FlyingCowsNCSU/FlyingCowsNCSU.github.io/images_and_videos/IMG_20230419_145311804_HDR.jpg

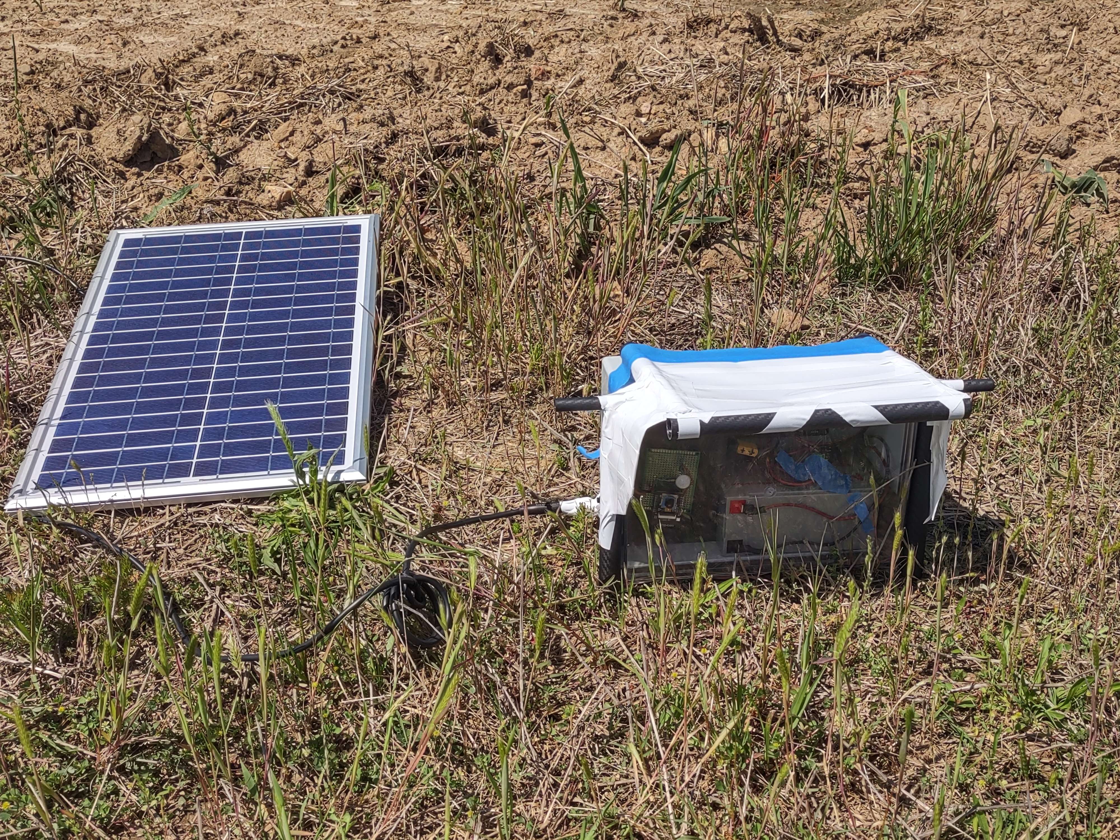
images_and_videos/IMG_20230419_145311804_HDR.jpg
