FlyingCowsNCSU/FlyingCowsNCSU.github.io/images_and_videos/IMG_20230425_180255801.jpg

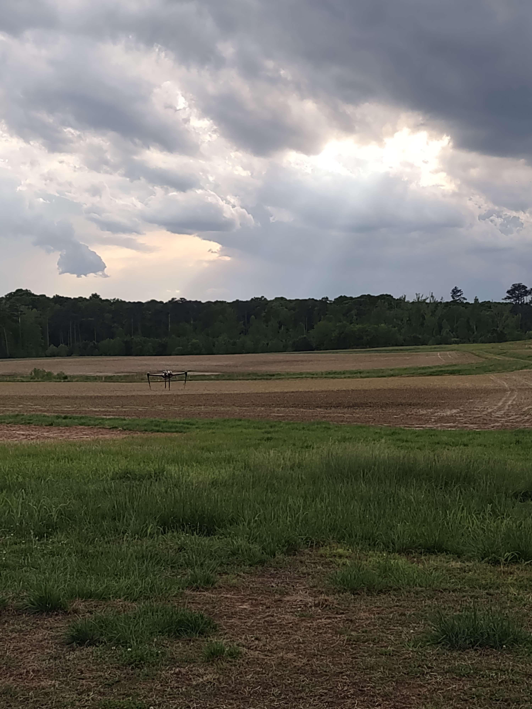
images_and_videos/IMG_20230425_180255801.jpg
