FlyingCowsNCSU/FlyingCowsNCSU.github.io/(commit log)

2023-05-03 added data file
    [ECE592FinalDeliverablesSpreadsheet.xlsx]
2023-05-03 hardware setup for drone updated
    [ECE592FinalDeliverablesSpreadsheet.xlsx, camera_trap_data.xlsx]
2023-05-03 Add links to Arduino library source
2023-05-03 Add camera trap stuff to readme
2023-05-03 attached documentation to build to the website
2023-05-03 Add camera_trap.ino
